K4zuki/mbedshield/README.md

# mbedshield
mbeDshield design and documents
