K4zuki/mbedshield/pic/mbeDshield060func.pptx

6-9V in

USB Host/Device(exclusive)

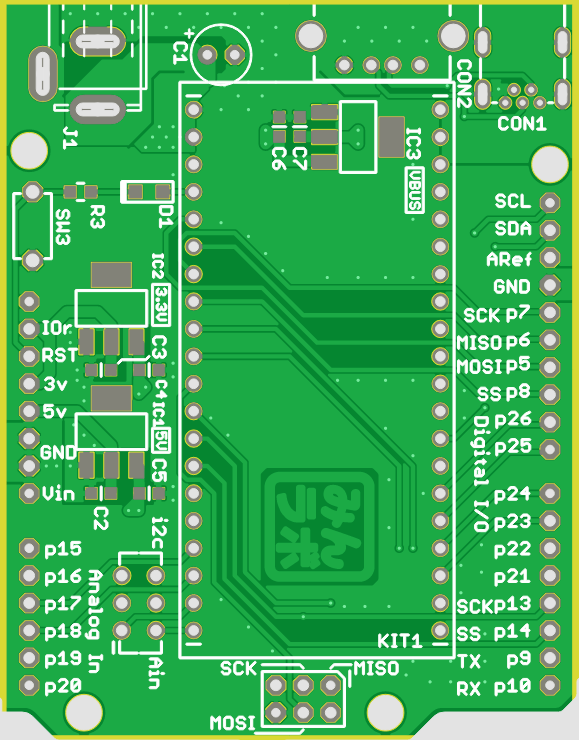
[picture p12: figure]

Reset

p27/SCL

p28/SDA

SCL
SDA

SCK
MISO
MOSI

Aref

GND

IOref

Reset

p7/D13

p6/D12

3.3V out

5V out

p5/D11

p8/D10

p26/D9

PwmOut

GND

GND

Vin

p25/D8

p24/D7

AnalogIn

AnalogOut

p15/A1

p23/D6

p22/D5

p16/A2

p17/A3

p13/SCK

p12/MISO

p21/D4

p13/D3

p18/A4

p19/A5

p20/A6

p14/D2

p9/D1

p10/D0

TX
RX

p11/MOSI
