K4zuki/mbedshield/pic/mbedshield040.sch.png

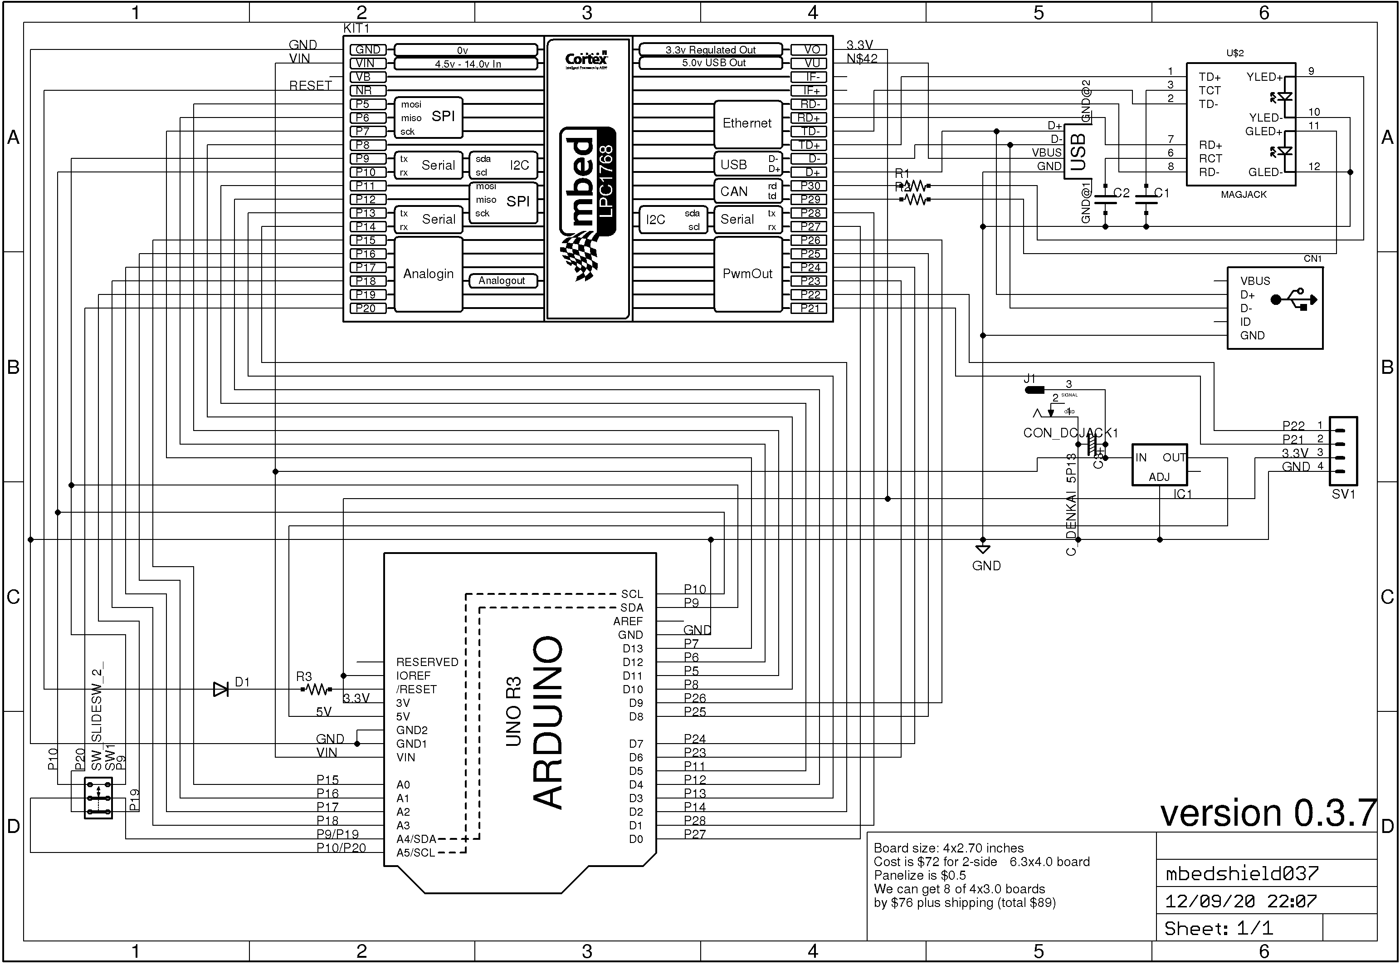
pic/mbedshield040.sch.png
