K4zuki/mbedshield/pic/mbedshield041.brd.png

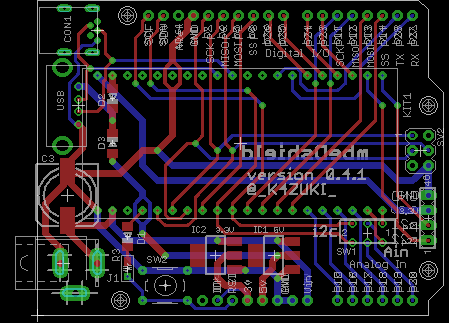
pic/mbedshield041.brd.png
