K4zuki/mbedshield/pic/mbedshield042.sch.png

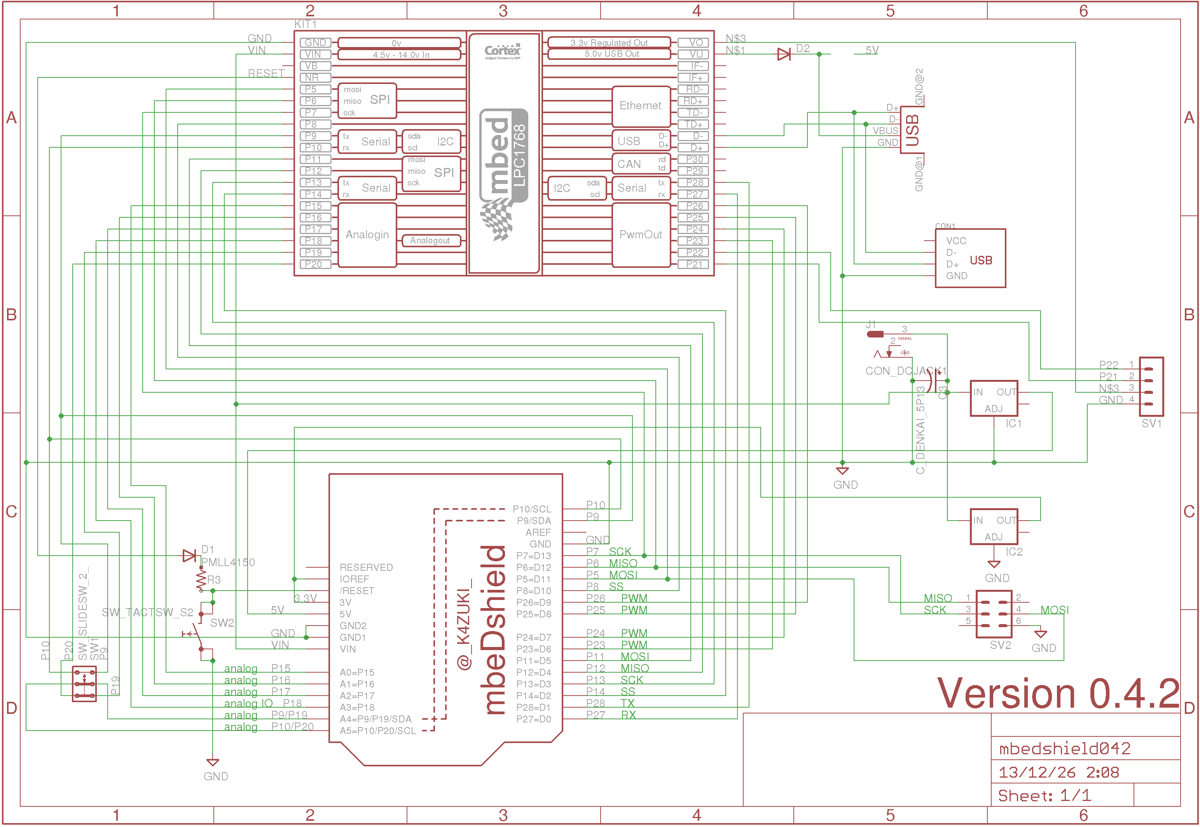
pic/mbedshield042.sch.png
