K4zuki/mbedshield/pic/mbedshield050.brd.png

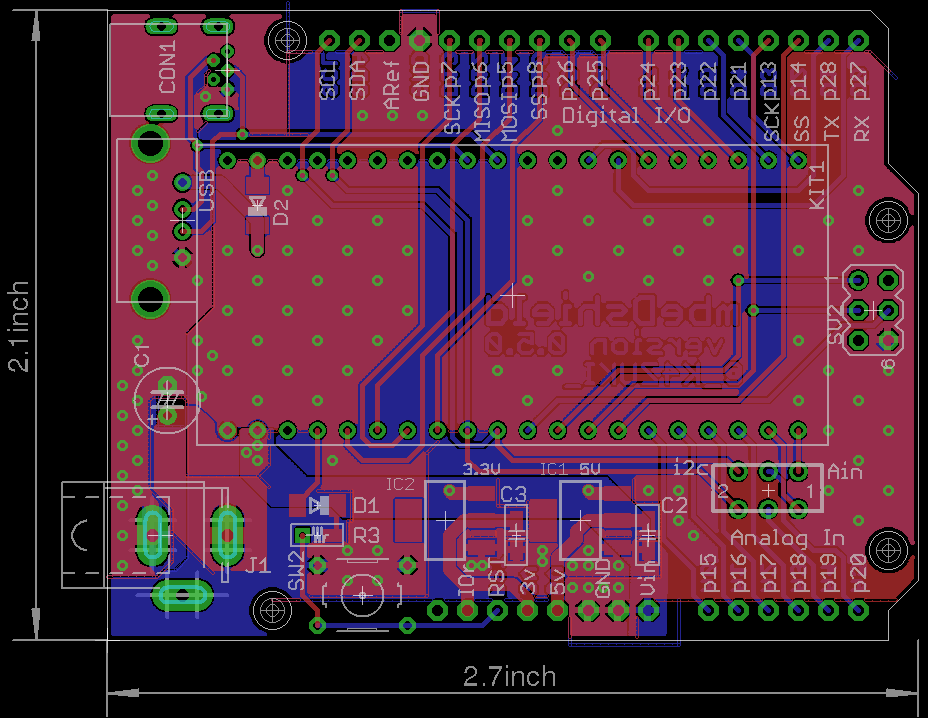
pic/mbedshield050.brd.png
