K4zuki/mbedshield/pic/mbedshield050.brd.white.png

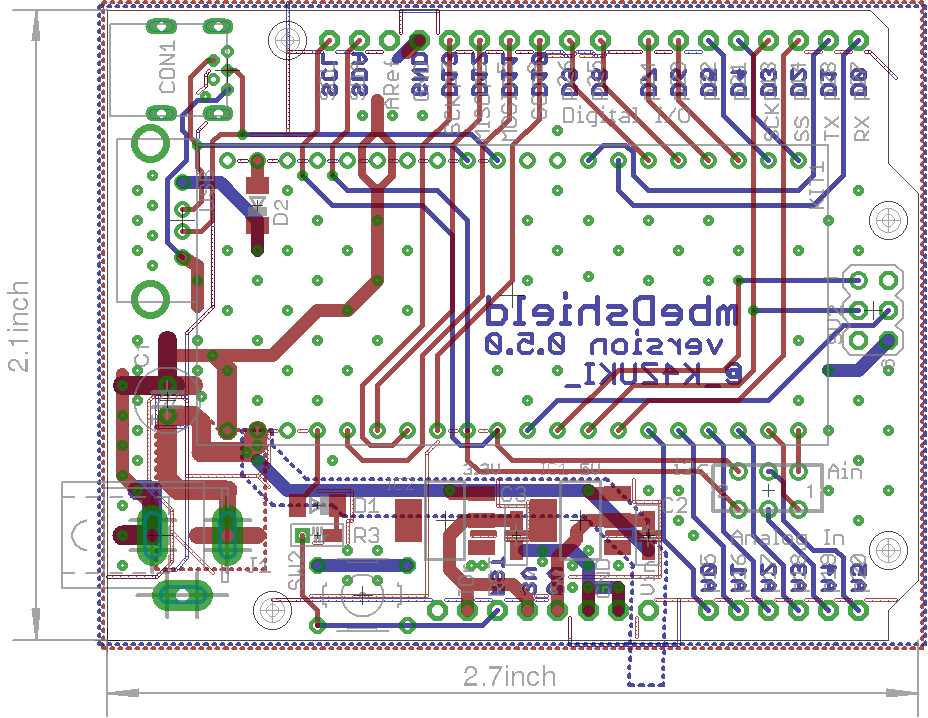
pic/mbedshield050.brd.white.png
