K4zuki/mbedshield/pic/mbedshield050.sch.png

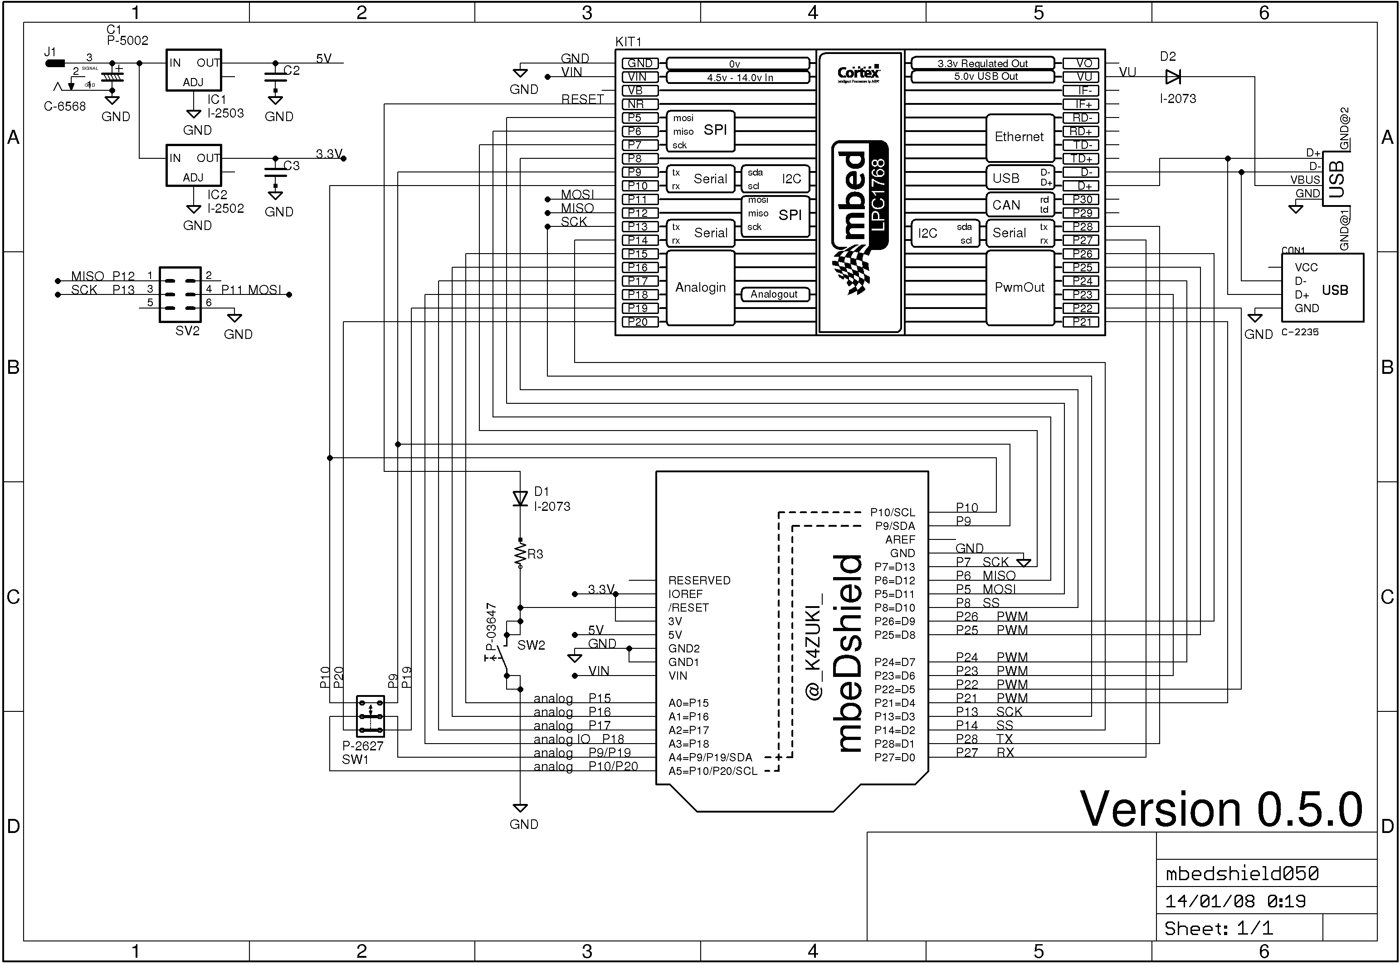
pic/mbedshield050.sch.png
