K4zuki/mbedshield/pic/mbedshield060_P.sch.png

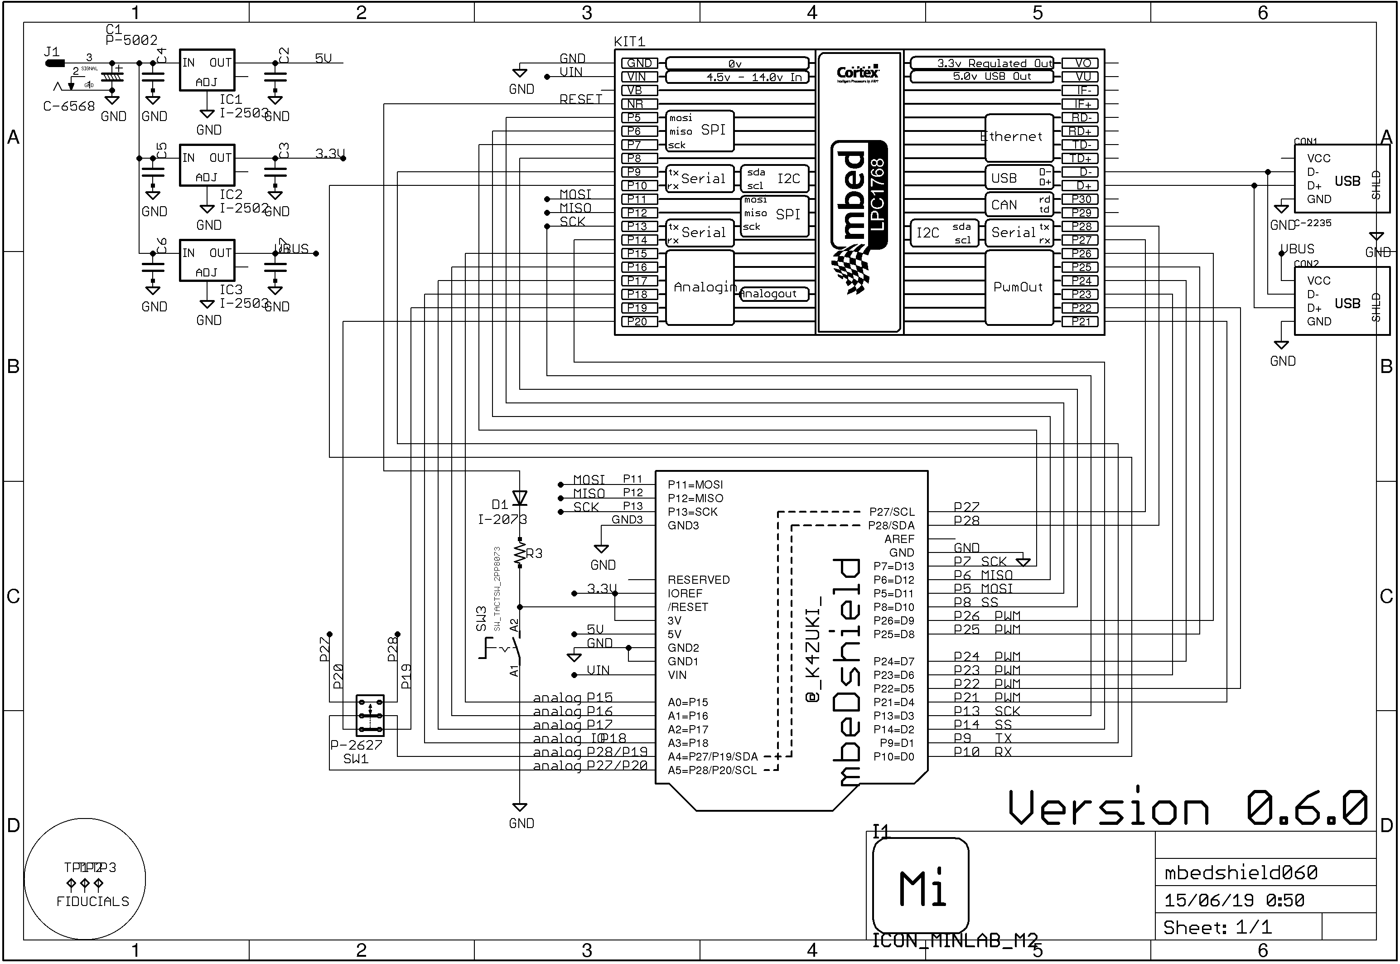
pic/mbedshield060_P.sch.png
