K4zuki/mbedshield/pic/mbedshield0399.brd.png

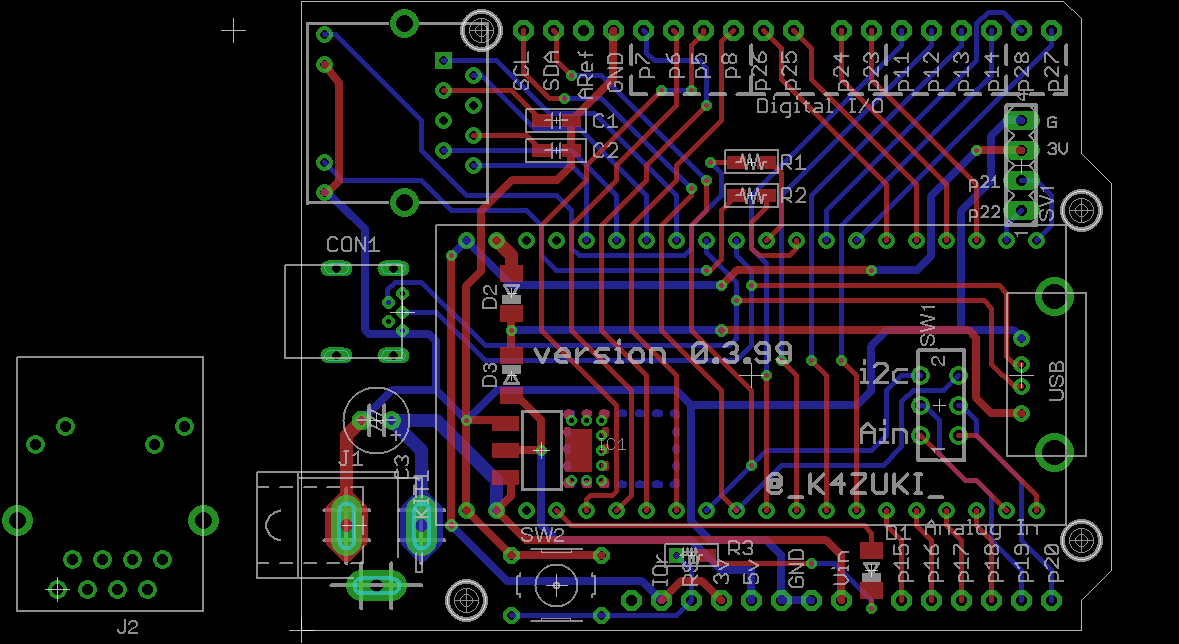
pic/mbedshield0399.brd.png
