K4zuki/mbedshield/pic/mbedshield0399.sch.png

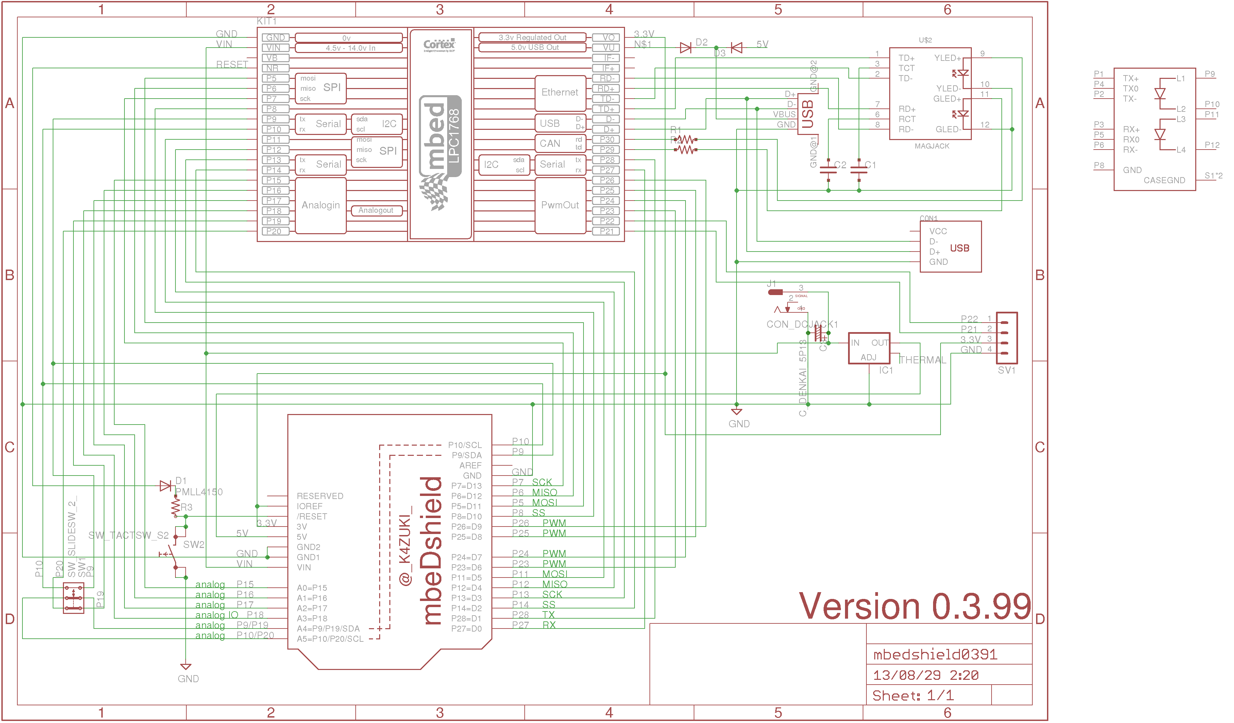
pic/mbedshield0399.sch.png
