K4zuki/mbedshield/pic/mbedshield042.brd.pdf

13/12/26 2:39 f=3.00 /home/yamamoto/eagle/eagle.old/mbedshield042.brd

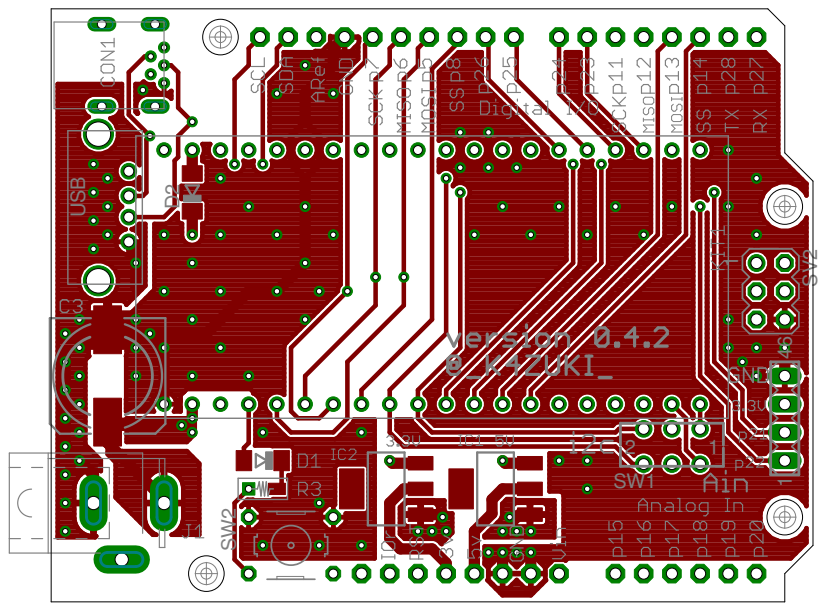
[picture p33: page 2]
