K4zuki/mbedshield/mbeduino010.eagle6.brd

## EAGLE design mbeduino010.eagle6.brd (2015-12-14)

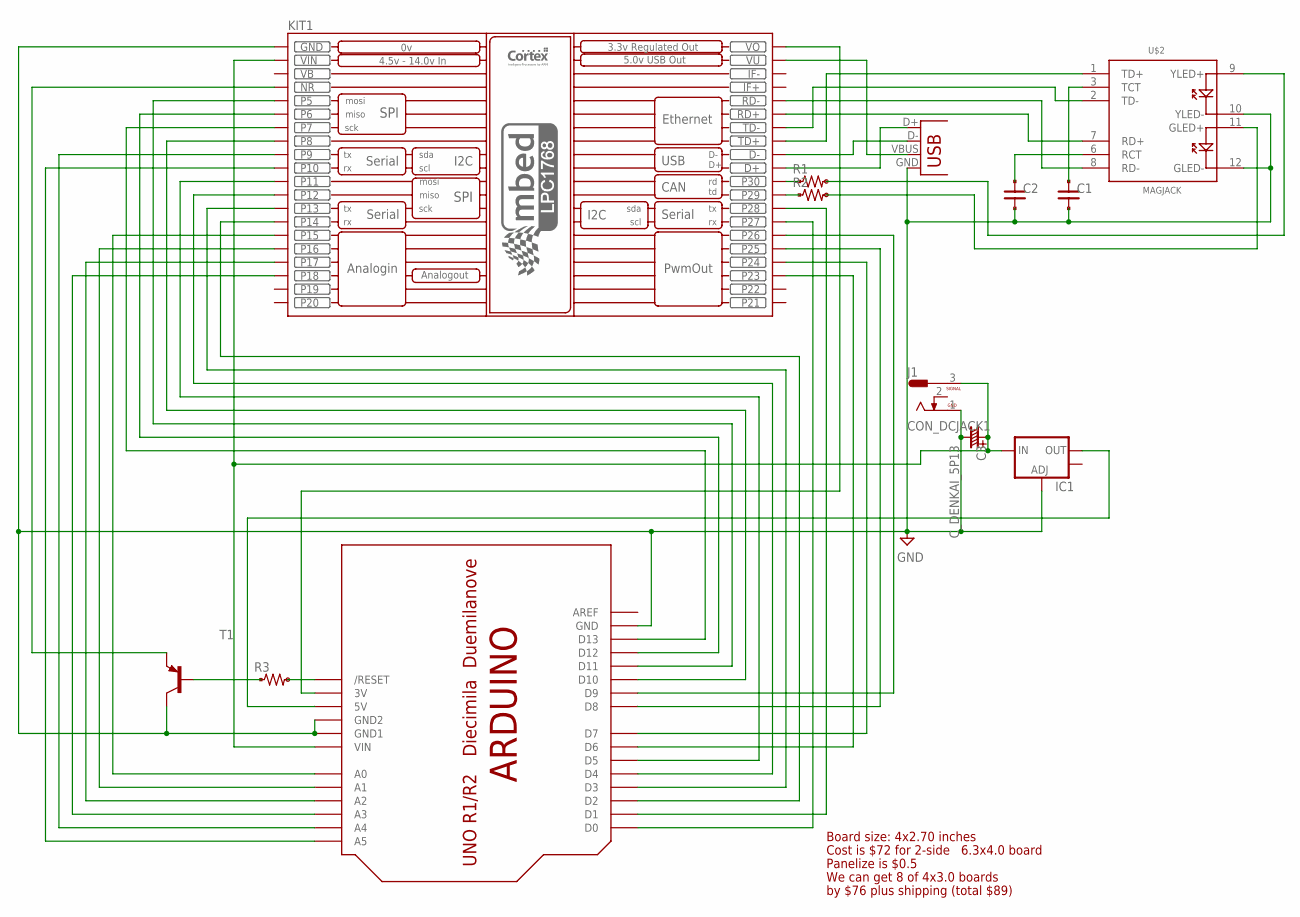
[picture p34: schematic mbeduino010.eagle6.sch]

Parts:
C1, C2: C_PAD_PAD_2125; CR_2125
C3: C_DENKAI_5P13; C_2.5PHI6
IC1: V_REG_LM1117SOT223; SOT223
J1: CON_DCJACK1; CON_DCJACK
KIT1: MBED_NXP_LPC1768; MBED-KIT
R1, R2, R3: R_US_PAD_VIA_2125; R_2125_PADVIA
T1: -PNP-SOT23-BCE; SOT23-BCE
U$1: ARDUINO-NOHOLE
U$2: MAGJACK
X1: USB-A-S

Connections:
GND: C1.2, C2.2, C3.-, IC1.1 (ADJ), J1.1 (3), KIT1.GND, T1.C, U$1.GND, U$1.GND1, U$1.GND2, U$2.10 (YLED-), U$2.12 (GLED-), X1.GND
unnamed: KIT1.NR, T1.E
unnamed: C3.+, IC1.3 (IN), J1.3 (1), KIT1.VIN, U$1.VIN
unnamed: KIT1.VOUT (VO), U$1.3V
unnamed: KIT1.P$15 (P15), U$1.A0
unnamed: KIT1.P$16 (P16), U$1.A1
unnamed: KIT1.P$17 (P17), U$1.A2
unnamed: KIT1.P$18 (P18), U$1.A3
unnamed: KIT1.P$9 (P9), U$1.A4
unnamed: KIT1.P$10 (P10), U$1.A5
unnamed: KIT1.P$27 (P27), U$1.D0
unnamed: KIT1.P$28 (P28), U$1.D1
unnamed: KIT1.P$14 (P14), U$1.D2
unnamed: KIT1.P$13 (P13), U$1.D3
unnamed: KIT1.P$12 (P12), U$1.D4
unnamed: KIT1.P$11 (P11), U$1.D5
unnamed: KIT1.P$23 (P23), U$1.D6
unnamed: KIT1.P$24 (P24), U$1.D7
unnamed: KIT1.P$25 (P25), U$1.D8
unnamed: KIT1.P$26 (P26), U$1.D9
unnamed: KIT1.P$8 (P8), U$1.D10
unnamed: KIT1.P$5 (P5), U$1.D11
unnamed: KIT1.P$6 (P6), U$1.D12
unnamed: KIT1.P$7 (P7), U$1.D13
unnamed: KIT1.D-, X1.D-
unnamed: KIT1.D+, X1.D+
unnamed: KIT1.VU, X1.VBUS
unnamed: R3.PAD, T1.B
unnamed: R3.VIA, U$1.RESET (/RESET)
unnamed: C1.1, U$2.3 (TCT)
unnamed: C2.1, U$2.6 (RCT)
unnamed: KIT1.RD+, U$2.7 (RD+)
unnamed: KIT1.RD-, U$2.8 (RD-)
unnamed: KIT1.TD-, U$2.2 (TD-)
unnamed: KIT1.TD+, U$2.1 (TD+)
unnamed: IC1.2 (OUT), U$1.5V
unnamed: KIT1.P$30 (P30), R1.PAD
unnamed: KIT1.P$29 (P29), R2.PAD
unnamed: R1.VIA, U$2.9 (YLED+)
unnamed: R2.VIA, U$2.11 (GLED+)
VB: KIT1.VB

Notes on the sheet:
Board size: 4x2.70 inches
Cost is $72 for 2-side
6.3x4.0 board
Panelize is $0.5
We can get 8 of 4x3.0 boards
by $76 plus shipping (total $89)

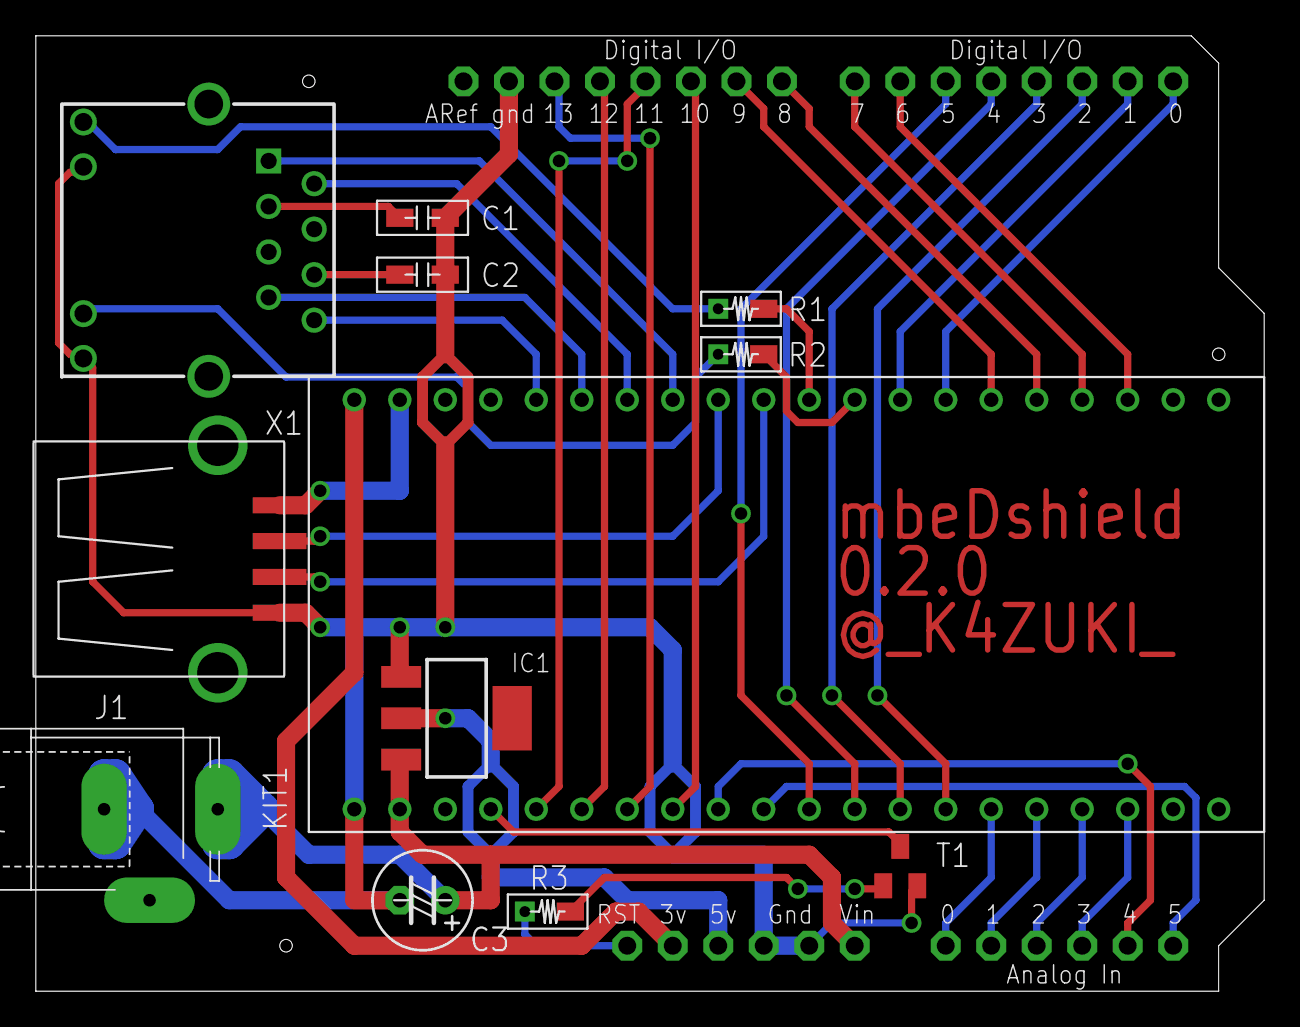
[picture p35: board mbeduino010.eagle6.brd from above]

Board: 2 copper layers, 68.6 x 53.3 mm, 13 parts (0 on the bottom side), 40 nets.
