K4zuki/mbedshield/mbedshield037.brd

## EAGLE design mbedshield037.brd (2015-12-09)

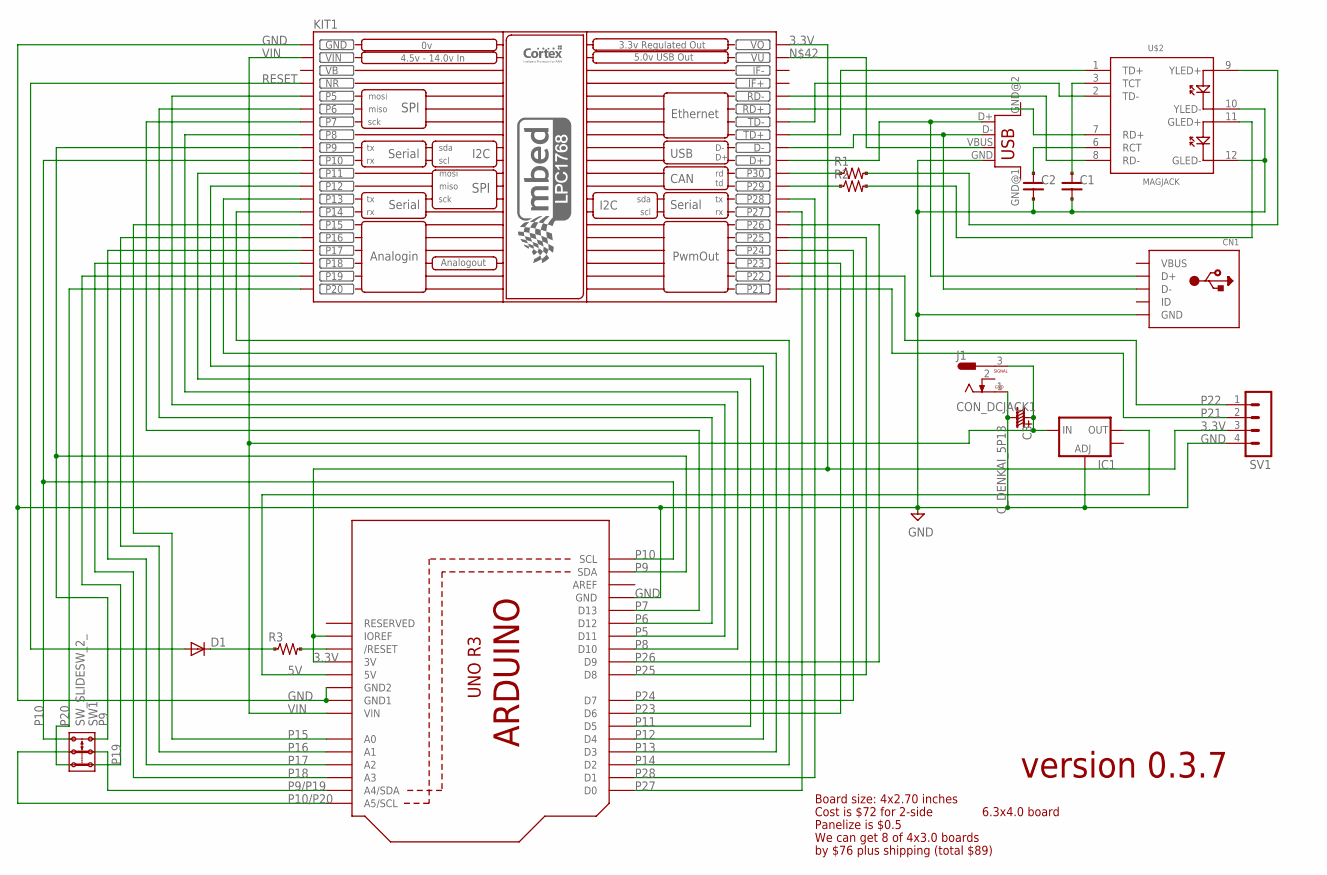
[picture p36: schematic mbedshield037.sch]

Parts:
C1, C2: C_PAD_PAD_2125; CR_2125
C3: C_DENKAI_5P13; C_2.5PHI6
CN1: USBMINIB; USB-MINIB
D1: DIODE_SMALL_FLAT_2V; DIODE_2125_2VIA
IC1: V_REG_LM1117SOT223; SOT223
J1: CON_DCJACK1; CON_DCJACK
KIT1: MBED_NXP_LPC1768; MBED-KIT
R1, R2, R3: R_US_PAD_PAD_1608; R_1608_PADPAD
SV1: MA04-1
SW1: SW_SLIDESW_2_; SW_SLIDE_2X2_1
U1: ARDUINOR3-DIMENSION; ARDUINOR3
U$2: MAGJACK
USB: USB; USB-FEMALE-A-PTH

Connections:
3.3V: KIT1.VOUT (VO), SV1.3, U1.3V, U1.IOREF
5V: IC1.2 (OUT), U1.5V
GND: C1.2, C2.2, C3.-, CN1.GND, IC1.1 (ADJ), J1.1 (3), KIT1.GND, SV1.4, U1.GND, U1.GND1, U1.GND2, U$2.10 (YLED-), U$2.12 (GLED-), USB.GND
unnamed: D1.K (C), R3.1
unnamed: R3.2, U1.RESET (/RESET)
unnamed: C1.1, U$2.3 (TCT)
unnamed: C2.1, U$2.6 (RCT)
unnamed: KIT1.RD+, U$2.7 (RD+)
unnamed: KIT1.RD-, U$2.8 (RD-)
unnamed: KIT1.TD-, U$2.2 (TD-)
unnamed: KIT1.TD+, U$2.1 (TD+)
unnamed: KIT1.P$30 (P30), R1.1
unnamed: KIT1.P$29 (P29), R2.1
unnamed: R1.2, U$2.9 (YLED+)
unnamed: R2.2, U$2.11 (GLED+)
unnamed: KIT1.VU, USB.VBUS
unnamed: CN1.D-, KIT1.D-, USB.D-
unnamed: CN1.D+, KIT1.D+, USB.D+
P5: KIT1.P$5 (P5), U1.D11
P6: KIT1.P$6 (P6), U1.D12
P7: KIT1.P$7 (P7), U1.D13
P8: KIT1.P$8 (P8), U1.D10
P9: KIT1.P$9 (P9), SW1.2.1, U1.SDA
P9/P19: SW1.COM.1, U1.A4 (A4/SDA)
P10: KIT1.P$10 (P10), SW1.2.2, U1.SCL
P10/P20: SW1.COM.2, U1.A5 (A5/SCL)
P11: KIT1.P$11 (P11), U1.D5
P12: KIT1.P$12 (P12), U1.D4
P13: KIT1.P$13 (P13), U1.D3
P14: KIT1.P$14 (P14), U1.D2
P15: KIT1.P$15 (P15), U1.A0
P16: KIT1.P$16 (P16), U1.A1
P17: KIT1.P$17 (P17), U1.A2
P18: KIT1.P$18 (P18), U1.A3
P19: KIT1.P$19 (P19), SW1.1.1
P20: KIT1.P$20 (P20), SW1.1.2
P21: KIT1.P$21 (P21), SV1.2
P22: KIT1.P$22 (P22), SV1.1
P23: KIT1.P$23 (P23), U1.D6
P24: KIT1.P$24 (P24), U1.D7
P25: KIT1.P$25 (P25), U1.D8
P26: KIT1.P$26 (P26), U1.D9
P27: KIT1.P$27 (P27), U1.D0
P28: KIT1.P$28 (P28), U1.D1
RESET: D1.A, KIT1.NR
VB: KIT1.VB
VBUS: CN1.VBUS
VIN: C3.+, IC1.3 (IN), J1.3 (1), KIT1.VIN, U1.VIN

Notes on the sheet:
Board size: 4x2.70 inches
Cost is $72 for 2-side
6.3x4.0 board
Panelize is $0.5
We can get 8 of 4x3.0 boards
by $76 plus shipping (total $89)
version 0.3.7

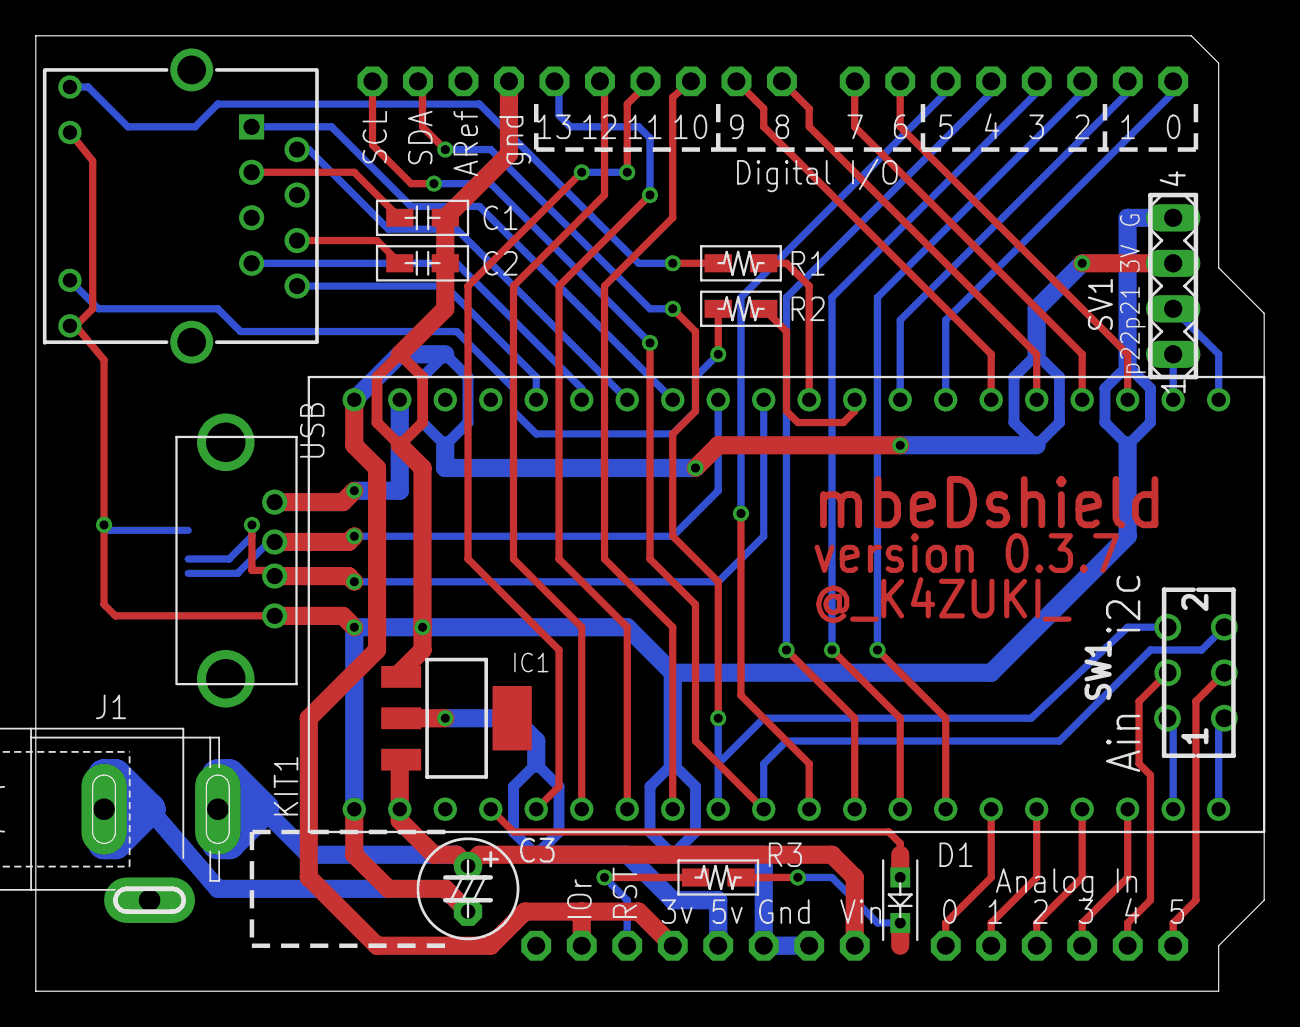
[picture p37: board mbedshield037.brd from above]

Board: 2 copper layers, 68.6 x 53.3 mm, 16 parts (1 on the bottom side), 46 nets.
