K4zuki/mbedshield/mbedshield041.brd

## EAGLE design mbedshield041.brd (2015-12-09)

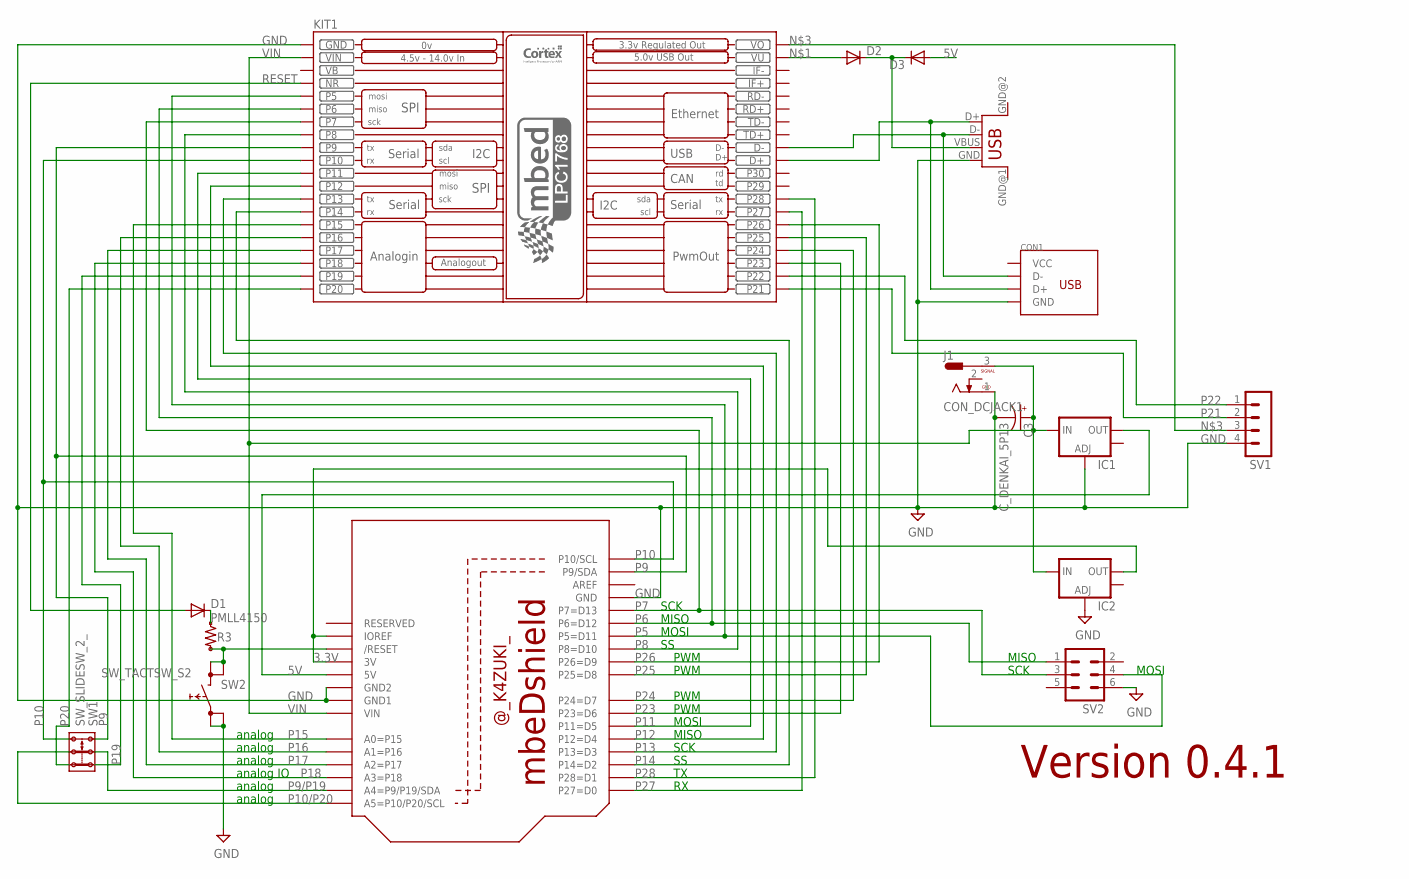
[picture p38: schematic mbedshield041.sch]

Parts:
C3: C_DENKAI_5P13; 153CLV-1014
CON1: CON_USB; CON_USB_MINIB_AKI
D1, D2, D3: PMLL4150; SOD80C
IC1, IC2: V_REG_LM1117SOT223; SOT223
J1: CON_DCJACK1; CON_DCJACK
KIT1: MBED_NXP_LPC1768; MBED-KIT
R3: R_US_PAD_VIA_2125; R_2125_PADVIA
SV1: MA04-1
SV2: MA03-2
SW1: SW_SLIDESW_2_; SW_SLIDE_2X2_1
SW2: SW_TACTSW_S2; SW_TACTSW_B3F-10XX
U$1: BOARD_MBEDSHIELD; BOARD_MBEDSHIOELD
USB: USB; USB-FEMALE-A-PTH

Connections:
3.3V: IC2.2 (OUT), U$1.3V, U$1.IOREF
5V: D3.A, IC1.2 (OUT), U$1.5V
GND: C3.-, CON1.GND, IC1.1 (ADJ), IC2.1 (ADJ), J1.1 (3), KIT1.GND, SV1.4, SV2.6, SW2.1 (0), SW2.2 (0), U$1.GND, U$1.GND1, U$1.GND2, USB.GND
unnamed: D2.A, KIT1.VU
unnamed: KIT1.VOUT (VO), SV1.3
unnamed: D1.C, R3.PAD
unnamed: R3.VIA, SW2.3 (1), SW2.4 (1), U$1.RESET (/RESET)
unnamed: D2.C, D3.C, USB.VBUS
unnamed: CON1.D-, KIT1.D-, USB.D-
unnamed: CON1.D+, KIT1.D+, USB.D+
P5: KIT1.P$5 (P5), SV2.4, U$1.D11 (P5=D11)
P6: KIT1.P$6 (P6), SV2.1, U$1.D12 (P6=D12)
P7: KIT1.P$7 (P7), SV2.3, U$1.D13 (P7=D13)
P8: KIT1.P$8 (P8), U$1.D10 (P8=D10)
P9: KIT1.P$9 (P9), SW1.2.1, U$1.SDA (P9/SDA)
P9/P19: SW1.COM.1, U$1.A4 (A4=P9/P19/SDA)
P10: KIT1.P$10 (P10), SW1.2.2, U$1.SCL (P10/SCL)
P10/P20: SW1.COM.2, U$1.A5 (A5=P10/P20/SCL)
P11: KIT1.P$11 (P11), U$1.D5 (P11=D5)
P12: KIT1.P$12 (P12), U$1.D4 (P12=D4)
P13: KIT1.P$13 (P13), U$1.D3 (P13=D3)
P14: KIT1.P$14 (P14), U$1.D2 (P14=D2)
P15: KIT1.P$15 (P15), U$1.A0 (A0=P15)
P16: KIT1.P$16 (P16), U$1.A1 (A1=P16)
P17: KIT1.P$17 (P17), U$1.A2 (A2=P17)
P18: KIT1.P$18 (P18), U$1.A3 (A3=P18)
P19: KIT1.P$19 (P19), SW1.1.1
P20: KIT1.P$20 (P20), SW1.1.2
P21: KIT1.P$21 (P21), SV1.2
P22: KIT1.P$22 (P22), SV1.1
P23: KIT1.P$23 (P23), U$1.D6 (P23=D6)
P24: KIT1.P$24 (P24), U$1.D7 (P24=D7)
P25: KIT1.P$25 (P25), U$1.D8 (P25=D8)
P26: KIT1.P$26 (P26), U$1.D9 (P26=D9)
P27: KIT1.P$27 (P27), U$1.D0 (P27=D0)
P28: KIT1.P$28 (P28), U$1.D1 (P28=D1)
RESET: D1.A, KIT1.NR
VB: KIT1.VB
VIN: C3.+, IC1.3 (IN), IC2.3 (IN), J1.3 (1), KIT1.VIN, U$1.VIN

Notes on the sheet:
MOSI
MISO
SCK
PWM
analog
analog IO
Version 0.4.1

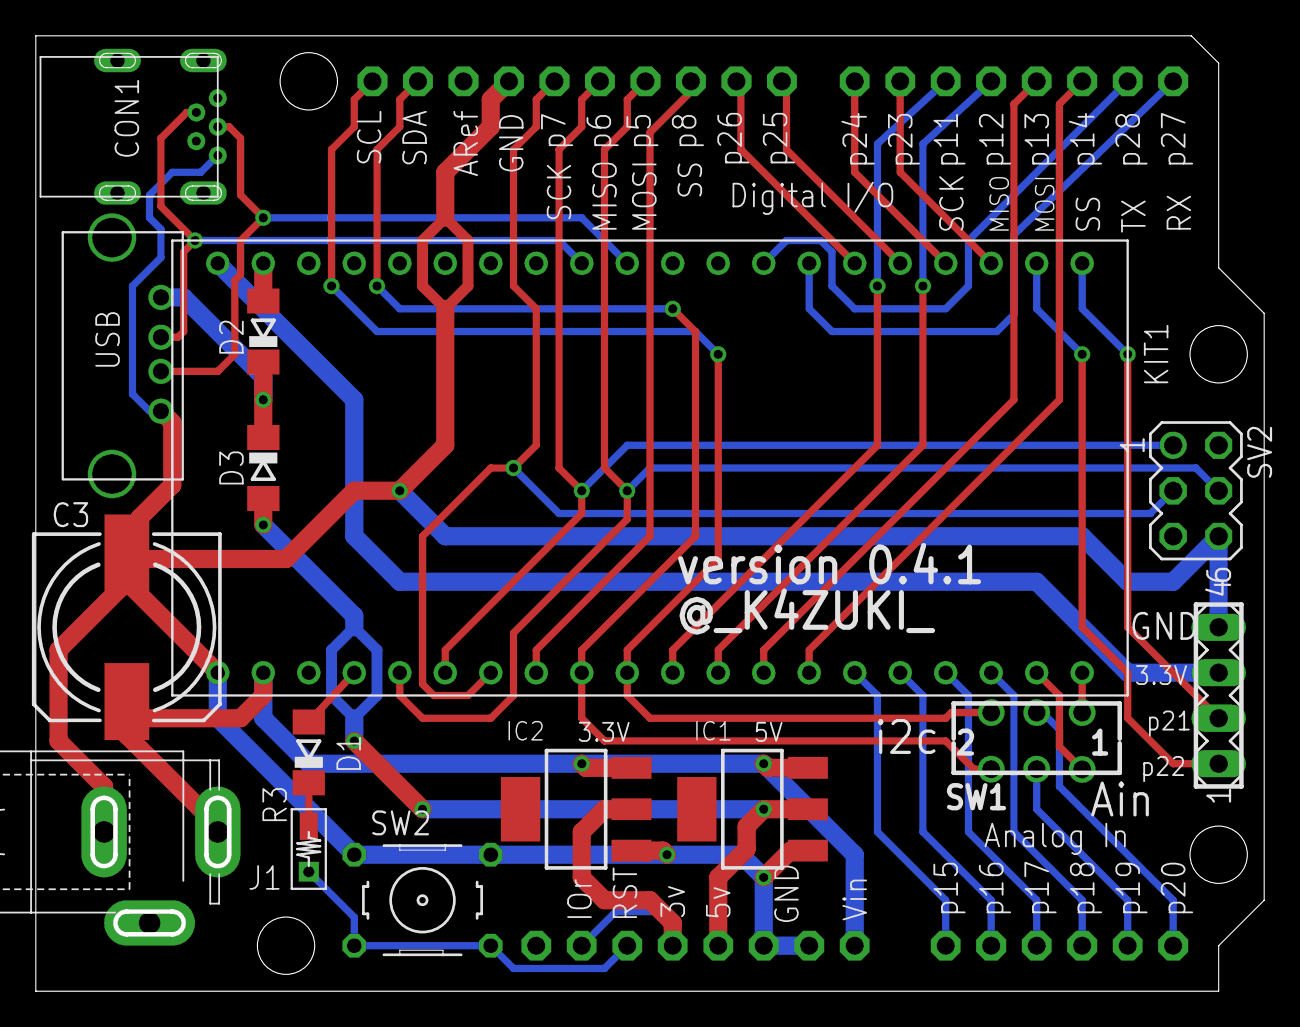
[picture p39: board mbedshield041.brd from above]

Board: 2 copper layers, 68.6 x 53.3 mm, 16 parts (0 on the bottom side), 38 nets.
