K4zuki/mbedshield/mbedshield060_P.brd

## EAGLE design mbedshield060_P.brd (2015-12-09)

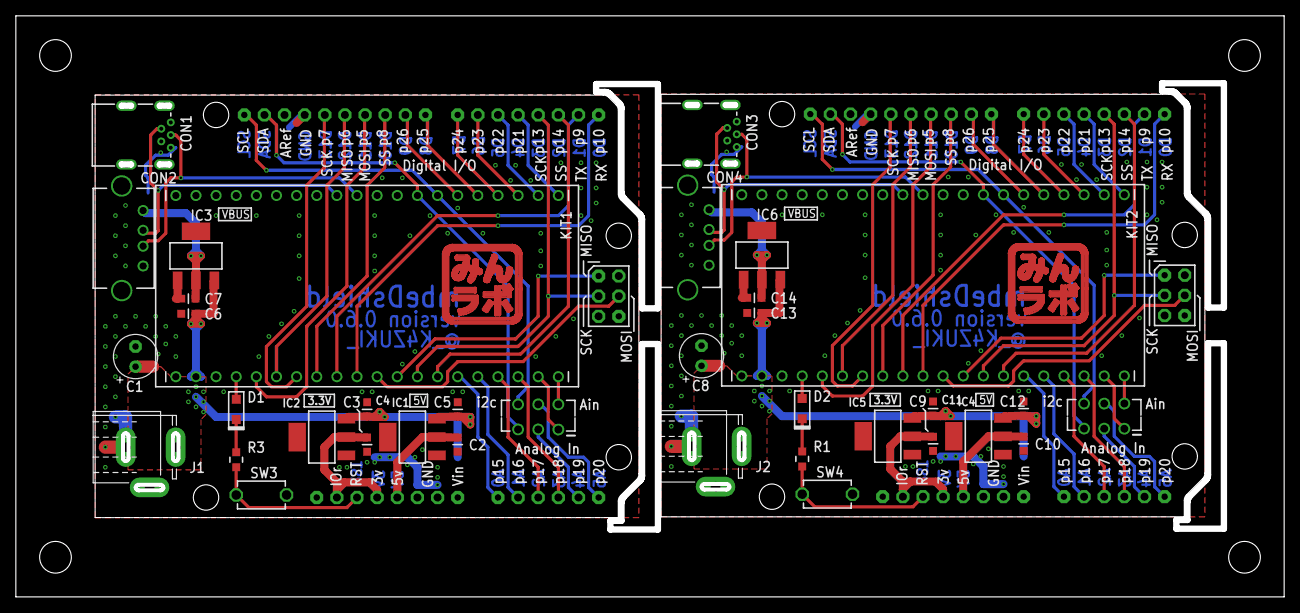
[picture p40: board mbedshield060_P.brd from above]

Board: 2 copper layers, 160.0 x 73.3 mm, 40 parts (0 on the bottom side), 72 nets.

Parts:
C1, C8: P-5002; C_2.5PHI6
C2, C3, C4, C5, C6, C7, C9, C10, C11, C12, C13, C14: CR_1608
CON1, CON3: C-2235; CON_USB_MINIB_AKI
CON2, CON4: CON_USB_A_SHIELD
D1, D2: I-2073; DIODE_2125
I1, I2: ICON_MINLAB_M2; ICON_MINLAB_2
IC1, IC3, IC4, IC6: I-2503; SOT223
IC2, IC5: I-2502; SOT223
J1, J2: C-6568; CON_DCJACK
KIT1, KIT2: MBED_NXP_LPC1768; MBED-KIT
R1, R3: R_1608_PADPAD
SW1, SW2: P-2627; SW_SLIDE_2X2_1
SW3, SW4: SW_TACTSW_2PP8073; SW_TACTSW_P8073
U$1, U$2: mbeDshield060; BOARD_MBEDSHIELD3

Connections:
3.3V: C3.1, IC2.2, U$1.3V, U$1.IOREF
3.3V1: C9.1, IC5.2, U$2.3V, U$2.IOREF
5V: C2.1, IC1.2, U$1.5V
5V1: C10.1, IC4.2, U$2.5V
GND: C1.-, C2.2, C3.2, C4.2, C5.2, C6.2, C7.2, CON1.GND, CON1.GND@1, CON1.GND@2, CON1.GND@3, CON1.GND@4, CON2.4, IC1.1, IC2.1, IC3.1, J1.1, KIT1.GND, SW3.A1, U$1.GND, U$1.GND1, U$1.GND2, U$1.GND3
GND1: C8.-, C9.2, C10.2, C11.2, C12.2, C13.2, C14.2, CON3.GND, CON3.GND@1, CON3.GND@2, CON3.GND@3, CON3.GND@4, CON4.4, IC4.1, IC5.1, IC6.1, J2.1, KIT2.GND, SW4.A1, U$2.GND, U$2.GND1, U$2.GND2, U$2.GND3
unnamed: CON1.D-, CON2.2, KIT1.D-
unnamed: R1.2, SW4.A2, U$2.RESET
unnamed: D2.K, R1.1
unnamed: CON3.D+, CON4.3, KIT2.D+
unnamed: CON3.D-, CON4.2, KIT2.D-
unnamed: D1.K, R3.1
unnamed: R3.2, SW3.A2, U$1.RESET
unnamed: CON1.D+, CON2.3, KIT1.D+
P1: KIT2.P$15, U$2.A0
P2: KIT2.P$16, U$2.A1
P3: KIT2.P$17, U$2.A2
P4: KIT2.P$18, U$2.A3
P5: KIT1.P$5, U$1.D11
P6: KIT1.P$6, U$1.D12
P7: KIT1.P$7, U$1.D13
P8: KIT1.P$8, U$1.D10
P9: KIT1.P$9, U$1.D1
P10: KIT1.P$10, U$1.D0
P11: KIT1.P$11, U$1.P11
P12: KIT1.P$12, U$1.P12
P13: KIT1.P$13, U$1.D3, U$1.P13
P14: KIT1.P$14, U$1.D2
P15: KIT1.P$15, U$1.A0
P16: KIT1.P$16, U$1.A1
P17: KIT1.P$17, U$1.A2
P18: KIT1.P$18, U$1.A3
P19: KIT1.P$19, SW1.1.1
P20: KIT1.P$20, SW1.1.2
P21: KIT1.P$21, U$1.D4
P22: KIT1.P$22, U$1.D5
P23: KIT1.P$23, U$1.D6
P24: KIT1.P$24, U$1.D7
P25: KIT1.P$25, U$1.D8
P26: KIT1.P$26, U$1.D9
P27: KIT1.P$27, SW1.2.2, U$1.SCL
P27/P1: SW2.COM.2, U$2.A5
P27/P20: SW1.COM.2, U$1.A5
P28: KIT1.P$28, SW1.2.1, U$1.SDA
P28/P1: SW2.COM.1, U$2.A4
P28/P19: SW1.COM.1, U$1.A4
P29: KIT2.P$9, U$2.D1
P30: KIT2.P$27, SW2.2.2, U$2.SCL
P31: KIT2.P$28, SW2.2.1, U$2.SDA
P32: KIT2.P$14, U$2.D2
P33: KIT2.P$13, U$2.D3, U$2.P13
P34: KIT2.P$12, U$2.P12
P35: KIT2.P$11, U$2.P11
P36: KIT2.P$23, U$2.D6
P37: KIT2.P$24, U$2.D7
P38: KIT2.P$25, U$2.D8
P39: KIT2.P$26, U$2.D9
P40: KIT2.P$8, U$2.D10
P41: KIT2.P$5, U$2.D11
P42: KIT2.P$6, U$2.D12
P43: KIT2.P$7, U$2.D13
P44: KIT2.P$10, U$2.D0
P45: KIT2.P$19, SW2.1.1
P46: KIT2.P$20, SW2.1.2
P47: KIT2.P$22, U$2.D5
P48: KIT2.P$21, U$2.D4
RESET: D1.A, KIT1.NR
RESET1: D2.A, KIT2.NR
VBUS: C7.1, CON2.1, IC3.2
VBUS1: C14.1, CON4.1, IC6.2
VIN: C1.+, C4.1, C5.1, C6.1, IC1.3, IC2.3, IC3.3, J1.3, KIT1.VIN, U$1.VIN
VIN1: C8.+, C11.1, C12.1, C13.1, IC4.3, IC5.3, IC6.3, J2.3, KIT2.VIN, U$2.VIN
