K4zuki/mbedshield/(commit log)

2015-12-09 PCB - initial commit
    0.3.7/0.4.0/0.4.1/0.4.2/0.5.0/0.6.0/0.6.0_P
    [mbedshield037.brd, mbedshield037.sch, mbedshield040.brd, mbedshield040.sch, mbedshield041.brd, mbedshield041.sch, mbedshield042.brd, mbedshield042.sch]
2015-12-09 rename to prototype.jpg
2015-12-14 add mbeduino010 schematic and layout in eagle6 format
    [mbeduino010.eagle6.brd, mbeduino010.eagle6.sch]
2015-12-14 add 0.6.0 schematic pic (portrait)
